lightskinloki/OpenBreeze/cad/stl/part4_volute_frontcover.stl

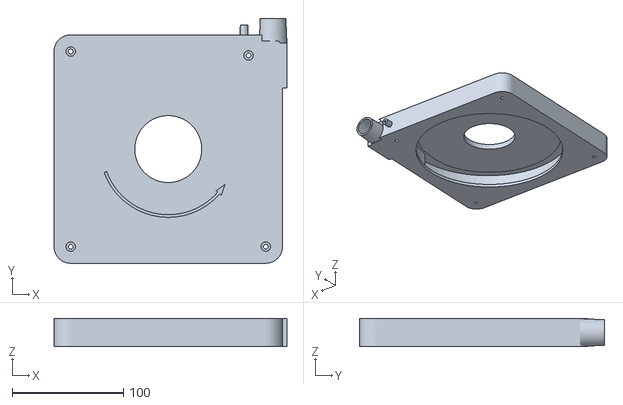
[picture p2: CAD file, 2026-10-22]
cad/stl/part4_volute_frontcover.stl
209.0 x 219.5 x 25.2
