lightskinloki/OpenBreeze/cad/stl/part8_intake_collar.stl

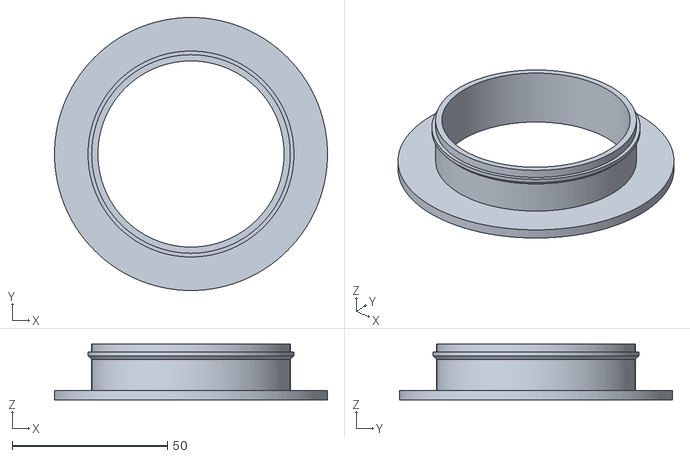
[picture p3: CAD file, 2026-10-22]
cad/stl/part8_intake_collar.stl
88.0 x 88.0 x 18.0
