lightskinloki/OpenBreeze/cad/stl/part3_volute_backplate.stl

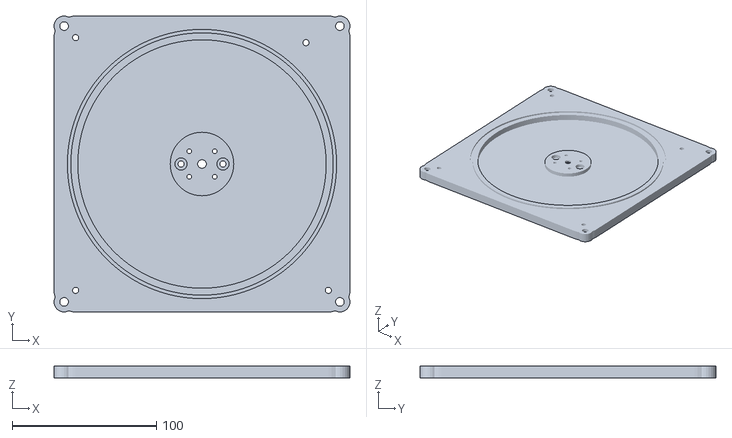
[picture p4: CAD file, 2026-10-22]
cad/stl/part3_volute_backplate.stl
205.0 x 205.0 x 8.40
