lightskinloki/OpenBreeze/cad/stl/part7_manometer_splash_traps.stl

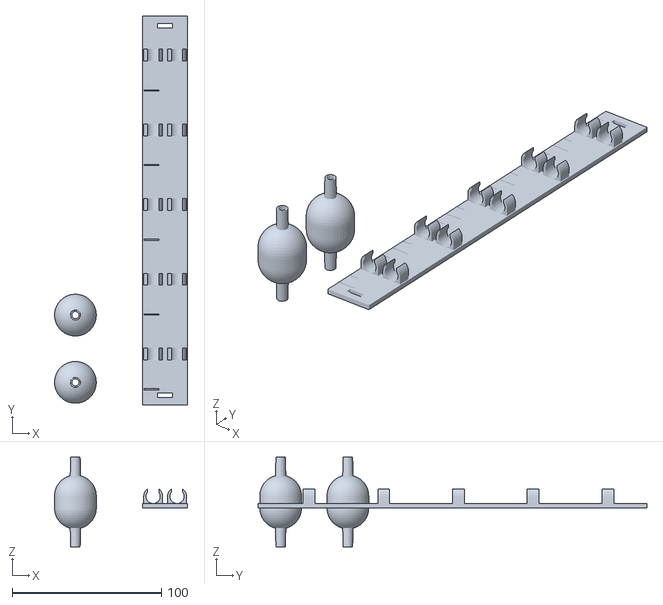
[picture p5: CAD file, 2026-10-22]
cad/stl/part7_manometer_splash_traps.stl
89.0 x 260.0 x 60.0
