lightskinloki/OpenBreeze/cad/stl/part6_safety_alarm_elbow.stl

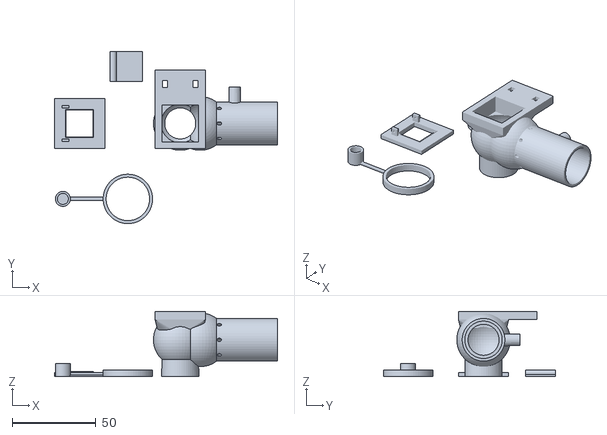
[picture p6: CAD file, 2026-10-22]
cad/stl/part6_safety_alarm_elbow.stl
133.0 x 102.8 x 39.0
