lightskinloki/OpenBreeze/cad/stl/part2_impeller_shroud.stl

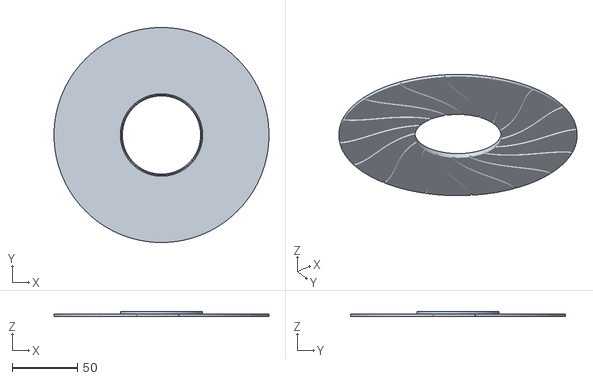
[picture p7: CAD file, 2026-10-22]
cad/stl/part2_impeller_shroud.stl
165.0 x 165.0 x 3.80
