lightskinloki/OpenBreeze/cad/stl/part1_impeller_disk.stl

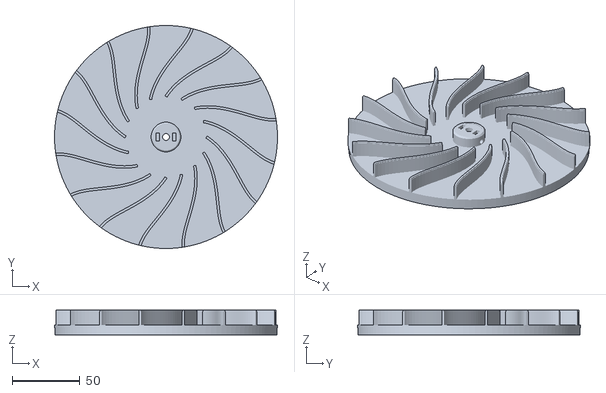
[picture p8: CAD file, 2026-10-22]
cad/stl/part1_impeller_disk.stl
165.0 x 165.0 x 18.3
