lightskinloki/OpenBreeze/cad/stl/part5_silencer_perforated_core.stl

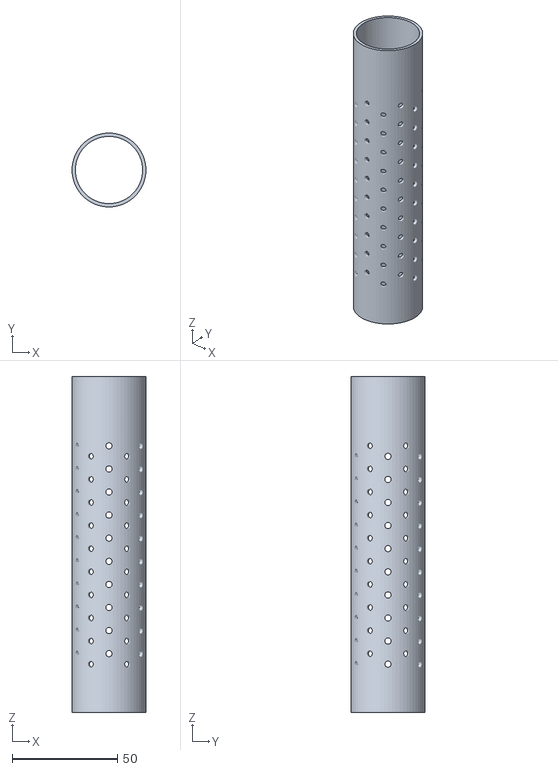
[picture p9: CAD file, 2026-10-21]
cad/stl/part5_silencer_perforated_core.stl
35.2 x 35.2 x 160.0
