lightskinloki/OpenBreeze/(list of files, cad)

Other CAD files:
reference/openpap/openpap.scad
