lightskinloki/OpenBreeze/(commit log)

2026-10-21 Initial checkpoint: V4 Clean-Path Radial architecture, adversarial FMEA, safety protocol, and OpenPAP prior-art audit
    [openpap.scad]
2026-10-21 Add complete scratch-build shopping list and required materials spec
2026-10-21 Complete Phase 4 CAD suite: 7 parametric OpenSCAD parts, Blender 5.2 generator, binary STLs, assembly render, and slicing guide
    [assembly_preview.scad, part1_impeller_disk.scad, part1_impeller_disk.stl, part2_impeller_shroud.scad, part2_impeller_shroud.stl, part3_volute_backplate.scad, part3_volute_backplate.stl, part4_volute_frontcover.scad]
2026-10-21 Add 2026-10-21 design review notes and obstructive-only scope
    AI-assisted review of the Phase 1-3 docs: math re-check, safety
    findings F-1 to F-7, open CAD decisions, central/mixed apnea
    background, and the stop-use policy for suspected central or mixed
    apnea. Linked from the README repository structure.
2026-10-21 Hardened V4.1 CAD & STLs: OpenSCAD pipeline, verified 220x220mm bed fit, 100% manifold STLs, continuous knife-edge AAV, rear balance rim
    [part1_impeller_disk.scad, part1_impeller_disk.stl, part2_impeller_shroud.scad, part2_impeller_shroud.stl, part3_volute_backplate.scad, part3_volute_backplate.stl, part4_volute_frontcover.scad, part4_volute_frontcover.stl]
2026-10-22 V4.2 CAD: sealed air path, printable housing, fixed elbow vents and taps
    Blower
    - Front cover prints front face down; intake collar split out as Part 8
    - Scroll and outlet duct floored inside the cover; gasket moved to r=92
    so it seals under solid plastic all the way round
    - Outlet duct -> round bore -> ISO 22mm spigot fully enclosed, with
    hose-cuff clearance; nothing below the parting plane
    - Pressure tap is a reachable 7.2mm barb (fits 1/4" ID tubing)
    - One assembly bolt moved to (72, 84), out of the outlet path
    - Stack-up gives 1.5mm rim, 3.0mm hub, 1.5mm eye-lip axial clearance,
    3.5mm radial, 6.3mm cutwater
    - Blades mirrored to match the CCW scroll; arrows with arrowheads
    - Grub-sc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
    [assembly_preview.scad, part1_impeller_disk.scad, part1_impeller_disk.stl, part2_impeller_shroud.scad, part2_impeller_shroud.stl, part3_volute_backplate.scad, part3_volute_backplate.stl, part4_volute_frontcover.scad]
